BeeFl/AngleSensor/(list of files, cad)

Other CAD files:
src/Objects/PWMn.obj
src/Objects/angle.obj
