BeeFl/AngleSensor/hardware/PCB_PCB_AngleSensor_bottom_2021-06-04.pdf

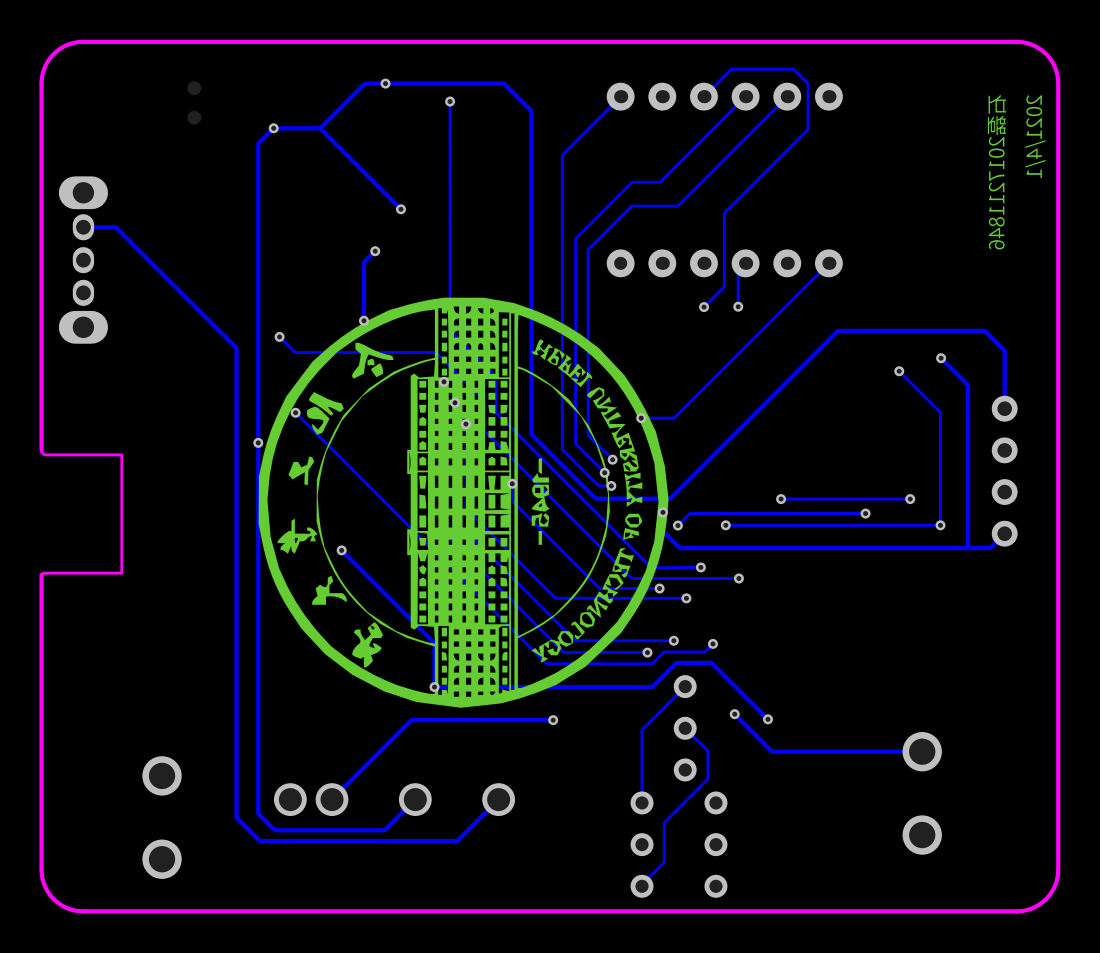
[picture p27: page 1]
