BeeFl/AngleSensor/hardware/PCB_PCB_AngleSensor_top_2021-06-04.pdf

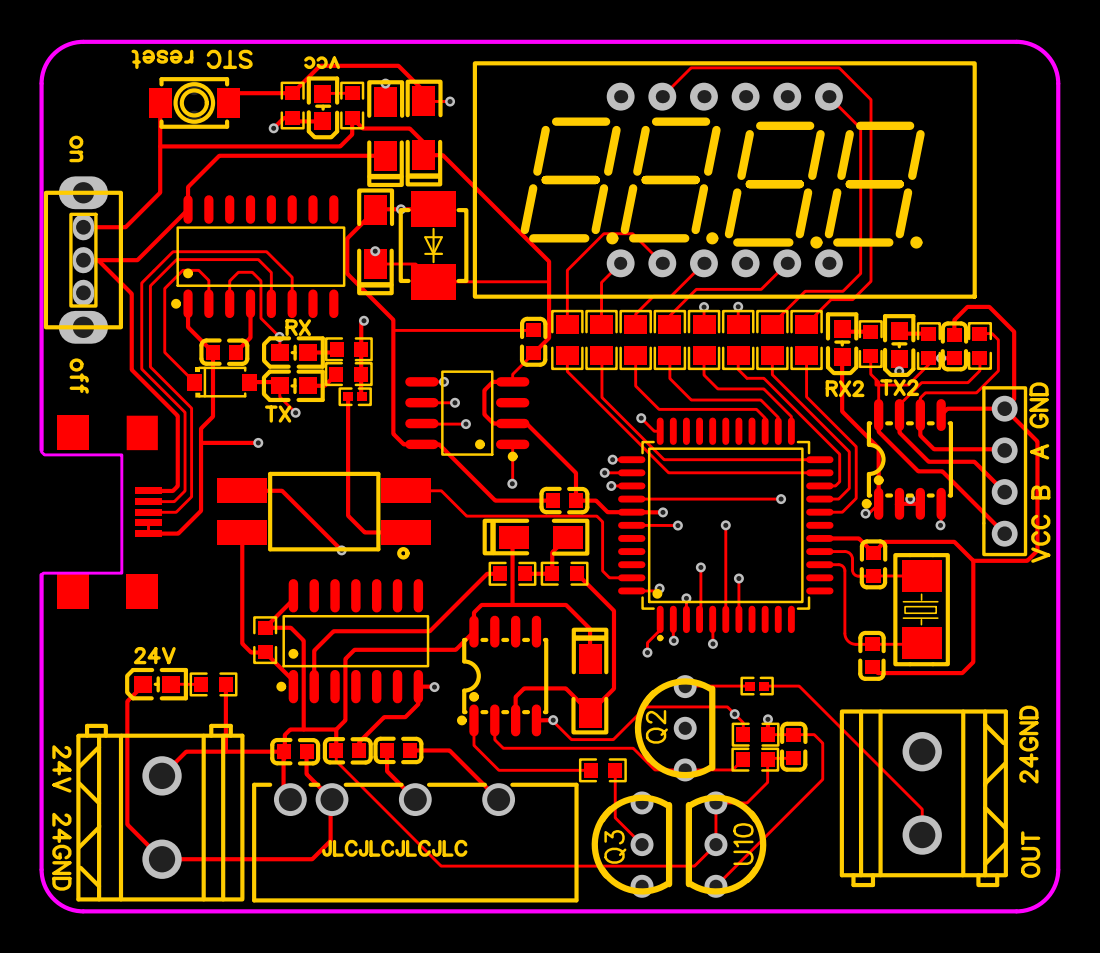
[picture p28: page 1]
