BeeFl/AngleSensor/hardware/Schematic_AngleSensor_2021-06-04.pdf

## MCU模块

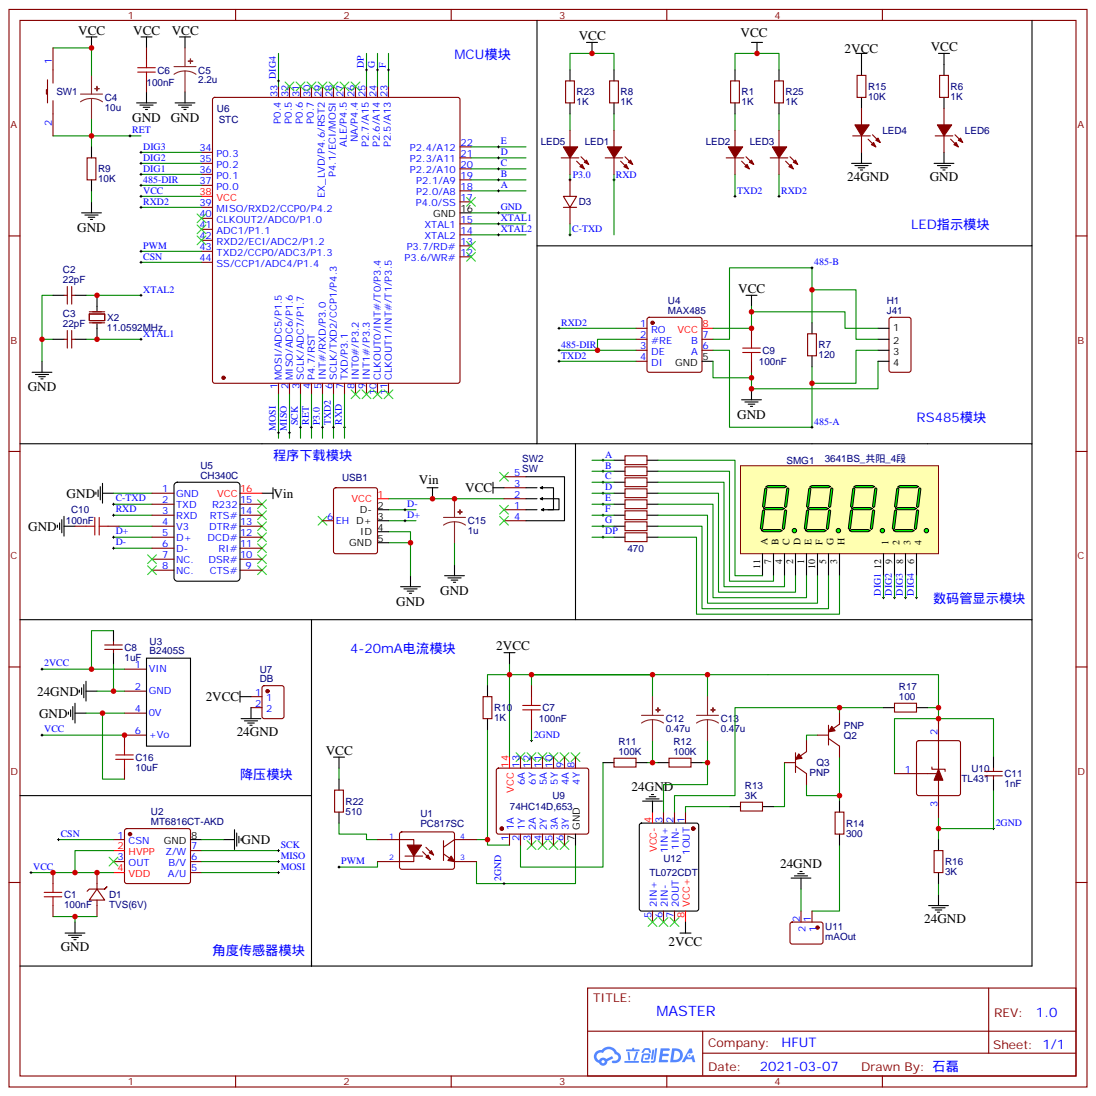
[picture p29: page 1]

SS/CCP1/ADC4/P1.4 44 TXD2/CCP0/ADC3/P1.3 43 RXD2/ECI/ADC2/P1.2 42 ADC1/P1.1 41 CLKOUT2/ADC0/P1.0 40 MISO/RXD2/CCP0/P4.2 39 VCC 38 P0.0 37 P0.1 36 P0.2 35 P0.3 34
